aalicc/HyPlantBox/calibration/DFRobot_pH_v2.ino

/* 
INSTRUCTIONS FOR CALIBRATION AND OTHER: https://wiki.dfrobot.com/Gravity__Analog_pH_Sensor_Meter_Kit_V2_SKU_SEN0161-V2
if you're using CONTROLLINO MAXI like me and the readings are wrong, please downlad and try my modified DFRobot library
link to the library: https://github.com/aalicc/DFRobot_pH_v2
*/

#include <Controllino.h>
#include "DFRobot_PH.h"
#include <EEPROM.h>

#define PH_PIN A1
float voltage,phValue,temperature = 25;
DFRobot_PH ph;

void setup()
{
    Serial.begin(19200);  
    ph.begin();
}

void loop()
{
    static unsigned long timepoint = millis();
    if(millis()-timepoint>1000U){                  //time interval: 1s
        timepoint = millis();
        //temperature = readTemperature();         // read your temperature sensor to execute temperature compensation
        voltage = analogRead(PH_PIN)/1024.0*5000;  // read the voltage
        phValue = ph.readPH(voltage,temperature);  // convert voltage to pH with temperature compensation
        Serial.print("temperature:");
        Serial.print(temperature,1);
        Serial.print("^C  pH:");
        Serial.println(phValue,2);
    }
    ph.calibration(voltage,temperature);           // calibration process by Serail CMD
}

float readTemperature()
{
  //add your code here to get the temperature from your temperature sensor
}
