aalicc/HyPlantBox/(commit log)

2023-05-22 Switch to a different css framework pt1 & cleanup
2023-05-24 Switch to bootstrap cdn +fetchAPI, ultrarangeronly
2023-06-20 add state machine
    Includes pumps, water level monitor, alarm
2023-06-20 add pH sensor code
    problems with the output, might be because the controllino out voltage is too low. Works well with Arduino Uno tho
2023-06-20 Add pin configuration
2023-06-21 modify, prepare for the next stages
2023-06-26 add temperature sensor, change pH code
    1st pump does not print responses. pH needs a temp compensation
2023-07-06 modify state machine and pumps
2023-07-18 add improved fan speed control
2023-07-18 replaced old pH with temp compensation one
    [state_machine.ino]
2023-07-18 add pH sensor
    Sensor supports temperature compensation. The folder also includes EEPROM file to delete calibration data.
2023-07-24 add main water pump work cycle
2023-07-25 device communication testing
2023-07-27 sh script, dev comms, connect sensor, py script
2023-08-02 add code for pH sensor
2023-08-02 add code for dosing pump
2023-08-02 add fan speed check
2023-08-02 comms work with fan
2023-08-08 update fan control
2023-08-31 adjust fan control
2023-09-01 replace EC for TDS! more reliable
    [state_machine.ino]
2023-09-05 add temp dependency + small corrections
    [state_machine.ino]
